byobc/debugger-rev4/firmware/myCMakeLists.txt

cmake_minimum_required(VERSION 3.22)

#
# This file is generated only once,
# and is not re-generated if converter is called multiple times.
#
# User is free to modify the file as much as necessary
#

# Setup compiler settings
set(CMAKE_C_STANDARD 17)
set(CMAKE_CXX_STANDARD 17)
set(CMAKE_C_STANDARD_REQUIRED ON)
set(CMAKE_C_EXTENSIONS ON)

# Define the build type
if(NOT CMAKE_BUILD_TYPE)
    set(CMAKE_BUILD_TYPE "Debug")
endif()

# Set the project name
set(CMAKE_PROJECT_NAME firmware)

# Include toolchain file
include("cmake/gcc-arm-none-eabi.cmake")

# Enable compile command to ease indexing with e.g. clangd
set(CMAKE_EXPORT_COMPILE_COMMANDS ON)

# Core project settings
project(${CMAKE_PROJECT_NAME})
message("Build type: " ${CMAKE_BUILD_TYPE})

# Enable CMake support for ASM and C languages
enable_language(C CXX ASM)

# Create an executable object type
add_executable(${CMAKE_PROJECT_NAME})

# Add STM32CubeMX generated sources
add_subdirectory(cmake/stm32cubemx)

# Link directories setup
target_link_directories(${CMAKE_PROJECT_NAME} PRIVATE
    # Add user defined library search paths
)

# Add sources to executable
target_sources(${CMAKE_PROJECT_NAME} PRIVATE
    # Add user sources here
    ${CMAKE_CURRENT_SOURCE_DIR}/Core/Src/real_main.cpp
    ${CMAKE_CURRENT_SOURCE_DIR}/Core/Src/crc.cpp
    ${CMAKE_CURRENT_SOURCE_DIR}/Core/Src/gpio.cpp
    ${CMAKE_CURRENT_SOURCE_DIR}/Core/Src/message.cpp
    ${CMAKE_CURRENT_SOURCE_DIR}/Core/Src/programmer.cpp
    ${CMAKE_CURRENT_SOURCE_DIR}/Core/Src/uart.cpp

    ${CMAKE_CURRENT_SOURCE_DIR}/lib/physicalW65C02/physicalw65c02.cpp
)

# Add include paths
target_include_directories(${CMAKE_PROJECT_NAME} PRIVATE
    # Add user defined include paths
    ${CMAKE_CURRENT_SOURCE_DIR}/lib/physicalW65C02
    ${CMAKE_CURRENT_SOURCE_DIR}/lib/sim6502
)

# Add project symbols (macros)
target_compile_definitions(${CMAKE_PROJECT_NAME} PRIVATE
    # Add user defined symbols
)

# Remove wrong libob.a library dependency when using cpp files
list(REMOVE_ITEM CMAKE_C_IMPLICIT_LINK_LIBRARIES ob)

# Add linked libraries
target_link_libraries(${CMAKE_PROJECT_NAME}
    stm32cubemx

    # Add user defined libraries
)

# tinyusb
include(${CMAKE_CURRENT_SOURCE_DIR}/lib/tinyusb/src/CMakeLists.txt)
tinyusb_target_add(${CMAKE_PROJECT_NAME})
