byobc/debugger-rev4/pcb/debugger-pcb-rev4.kicad_pcb

## KiCad design pcb/debugger-pcb-rev4.kicad_pcb (2026-01-02)

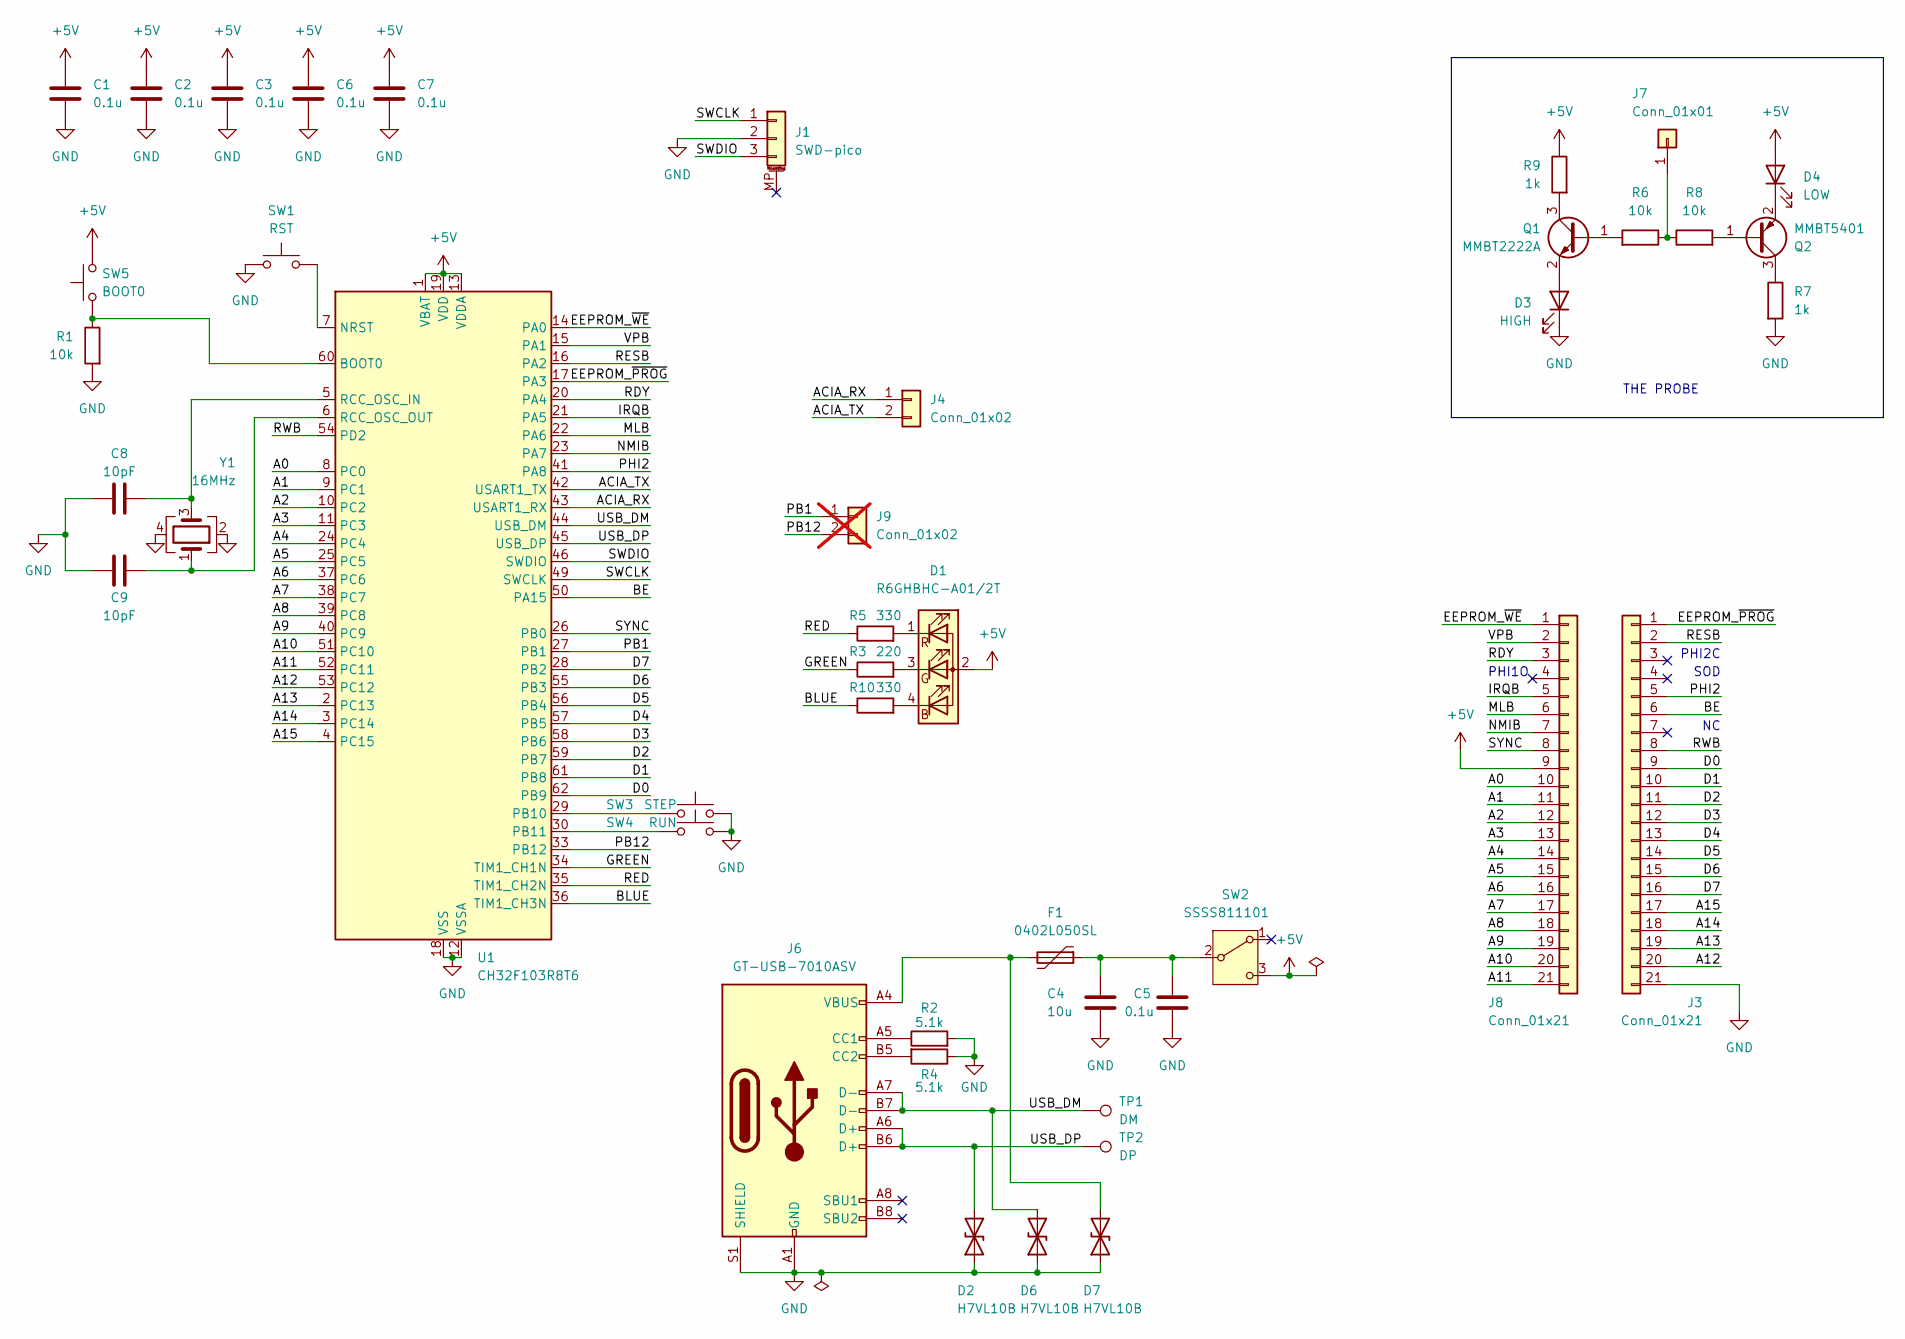
[picture p1: schematic debugger-pcb-rev4.kicad_sch]

Parts:
C1, C2, C3, C5, C6, C7: 0.1u; C_0402_1005Metric; JLC P/N C1525
C4: 10u; C_0402_1005Metric; JLC P/N C15525
C8, C9: 10pF; C_0402_1005Metric; JLC P/N C32949
D1: R6GHBHC-A01/2T; Everlight_0606; JLC P/N C60105
D2, D6, D7: H7VL10B; D_SOD-882; JLC P/N C20615787
D3: HIGH; LED_0805_2012Metric; JLC P/N C2297
D4: LOW; LED_0805_2012Metric; JLC P/N C98225
F1: 0402L050SL; Fuse_0402_1005Metric; JLC P/N C206938
J1: SWD-pico; JST_SH_BM03B-SRSS-TB_1x03-1MP_P1.00mm_Vertical; JLC P/N C3029333
J3, J8: Conn_01x21; PinHeader_1x21_P2.54mm_Vertical_nosilk
J4: Conn_01x02; PinHeader_1x02_P2.54mm_Vertical
J6: GT-USB-7010ASV; USB_C_Receptacle_GCT_USB4105-xx-A_16P_TopMnt_Horizontal; JLC P/N C2988369
J7: Conn_01x01; PinHeader_1x01_P2.54mm_Vertical
J9: Conn_01x02; PinHeader_1x02_P2.54mm_Vertical; not fitted
Q1: MMBT2222A; SOT-523; JLC P/N C94417
Q2: MMBT5401; SOT-523; JLC P/N C2836079
R1, R6, R8: 10k; R_0402_1005Metric; JLC P/N C25744
R2, R4: 5.1k; R_0402_1005Metric; JLC P/N C25905
R3: 220; R_0402_1005Metric; JLC P/N C25091
R5, R10: 330; R_0402_1005Metric; JLC P/N C25104
R7, R9: 1k; R_0402_1005Metric; JLC P/N C11702
SW1: RST; SW_Push_SPST_TS-1088; JLC P/N C720477
SW2: SSSS811101; SW_SPDT_PCM12; JLC P/N C109335
SW3: STEP; SW_Push_SPST_TS-1088; JLC P/N C720477
SW4: RUN; SW_Push_SPST_TS-1088; JLC P/N C720477
SW5: BOOT0; SW_Push_SPST_TS-1088; JLC P/N C720477
TP1: DM; TestPoint_Pad_1.0x1.0mm
TP2: DP; TestPoint_Pad_1.0x1.0mm
U1: CH32F103R8T6; LQFP-64_10x10mm_P0.5mm; JLC P/N C2683478
Y1: 16MHz; Crystal_SMD_3225-4Pin_3.2x2.5mm; JLC P/N C13738

Connections:
+5V: C1.1, C2.1, C3.1, C6.1, C7.1, D1.2 (A), D4.2 (A), J8.9, R9.1, SW2.3 (C), SW5.1, U1.1 (VBAT), U1.13 (VDDA), U1.19 (VDD), U1.32 (VDD), U1.48 (VDD), U1.64 (VDD)
/A0: J8.10, U1.8 (PC0)
/A1: J8.11, U1.9 (PC1)
/A2: J8.12, U1.10 (PC2)
/A3: J8.13, U1.11 (PC3)
/A4: J8.14, U1.24 (PC4)
/A5: J8.15, U1.25 (PC5)
/A6: J8.16, U1.37 (PC6)
/A7: J8.17, U1.38 (PC7)
/A8: J8.18, U1.39 (PC8)
/A9: J8.19, U1.40 (PC9)
/A10: J8.20, U1.51 (PC10)
/A11: J8.21, U1.52 (PC11)
/A12: J3.20, U1.53 (PC12)
/A13: J3.19, U1.2 (PC13)
/A14: J3.18, U1.3 (PC14)
/A15: J3.17, U1.4 (PC15)
/ACIA_RX: J4.1, U1.43 (USART1_RX)
/ACIA_TX: J4.2, U1.42 (USART1_TX)
/BE: J3.6, U1.50 (PA15)
/BLUE: R10.1, U1.36 (TIM1_CH3N)
/D0: J3.9, U1.62 (PB9)
/D1: J3.10, U1.61 (PB8)
/D2: J3.11, U1.59 (PB7)
/D3: J3.12, U1.58 (PB6)
/D4: J3.13, U1.57 (PB5)
/D5: J3.14, U1.56 (PB4)
/D6: J3.15, U1.55 (PB3)
/D7: J3.16, U1.28 (PB2)
/EEPROM_~PROG: J3.1, U1.17 (PA3)
/EEPROM_~WE: J8.1, U1.14 (PA0)
/GREEN: R3.1, U1.34 (TIM1_CH1N)
/IRQB: J8.5, U1.21 (PA5)
/MLB: J8.6, U1.22 (PA6)
/NMIB: J8.7, U1.23 (PA7)
/PB1: J9.1, U1.27 (PB1)
/PB12: J9.2, U1.33 (PB12)
/PHI2: J3.5, U1.41 (PA8)
/RDY: J8.3, U1.20 (PA4)
/RED: R5.1, U1.35 (TIM1_CH2N)
/RESB: J3.2, U1.16 (PA2)
/RWB: J3.8, U1.54 (PD2)
/SWCLK: J1.1, U1.49 (SWCLK)
/SWDIO: J1.3, U1.46 (SWDIO)
/SYNC: J8.8, U1.26 (PB0)
/USB_DM: D6.2 (A2), J6.A7 (D-), J6.B7 (D-), TP1.1, U1.44 (USB_DM)
/USB_DP: D2.2 (A2), J6.A6 (D+), J6.B6 (D+), TP2.1, U1.45 (USB_DP)
/VPB: J8.2, U1.15 (PA1)
GND: C1.2, C2.2, C3.2, C4.2, C5.2, C6.2, C7.2, C8.1, C9.1, D2.1 (A1), D3.1 (K), D6.1 (A1), D7.1 (A1), J1.2, J3.21, J6.A1 (GND), J6.A12 (GND), J6.B1 (GND), J6.B12 (GND), J6.S1 (SHIELD), R1.2, R2.2, R4.1, R7.2, SW1.1, SW3.1, SW4.1, U1.12 (VSSA), U1.18 (VSS), U1.31 (VSS), U1.47 (VSS), U1.63 (VSS), Y1.2, Y1.4
unnamed: D1.4 (BK), R10.2
unnamed: D1.3 (GK), R3.2
unnamed: D1.1 (RK), R5.2
unnamed: D3.2 (A), Q1.2 (E)
unnamed: D4.1 (K), Q2.2 (E)
unnamed: D7.2 (A2), F1.2, J6.A4 (VBUS), J6.A9 (VBUS), J6.B4 (VBUS), J6.B9 (VBUS)
unnamed: J6.A5 (CC1), R2.1
unnamed: J6.B5 (CC2), R4.2
unnamed: J7.1, R6.1, R8.1
unnamed: Q1.1 (B), R6.2
unnamed: Q1.3 (C), R9.2
unnamed: Q2.1 (B), R8.2
unnamed: Q2.3 (C), R7.1
unnamed: C4.1, C5.1, F1.1, SW2.2 (B)
unnamed: R1.1, SW5.2, U1.60 (BOOT0)
unnamed: SW1.2, U1.7 (NRST)
unnamed: SW3.2, U1.29 (PB10)
unnamed: SW4.2, U1.30 (PB11)
unnamed: C8.2, U1.5 (RCC_OSC_IN), Y1.3
unnamed: C9.2, U1.6 (RCC_OSC_OUT), Y1.1

Notes on the sheet:
SOD
THE PROBE
PHI2C
PHI1O

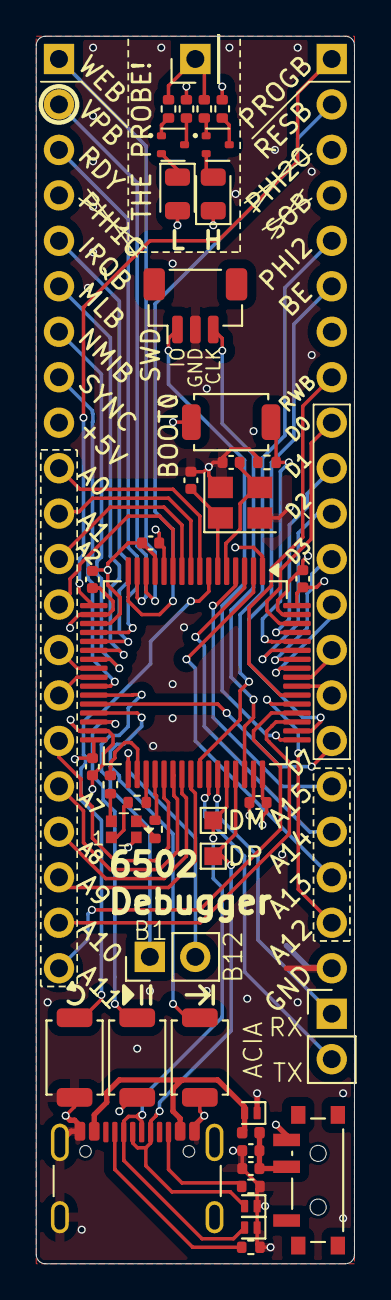
[picture p2: board debugger-pcb-rev4.kicad_pcb from above]

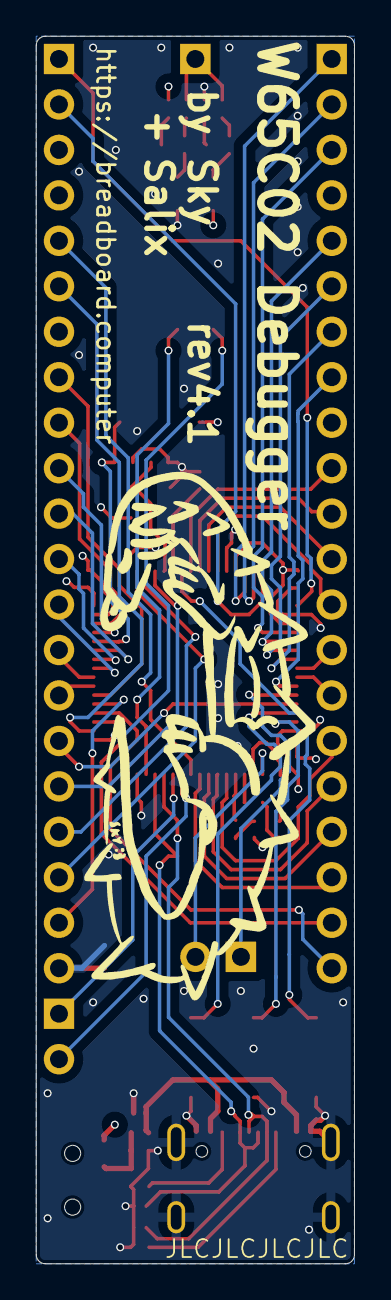
[picture p3: board debugger-pcb-rev4.kicad_pcb from below]

Board: 4 copper layers, 17.8 x 68.6 mm, 44 parts (2 on the bottom side), 69 nets.
