byobc/debugger-rev4/firmware/firmware.ioc

Mcu.UserName=STM32F103R8Tx
PA10.Signal=USART1_RX
PA11.Signal=USB_DM
PA12.Signal=USB_DP
PA7.Signal=TIM1_CH1N
PA9.Signal=USART1_TX
PB0.Signal=TIM1_CH2N
PB1.Signal=TIM1_CH3N
PD0-OSC_IN.Signal=RCC_OSC_IN
PD1-OSC_OUT.Signal=RCC_OSC_OUT
