byobc/debugger-rev4/firmware/Core/Inc/message.h

#pragma once

#include "sim.h"
#include <stdint.h>

struct BusState {
	uint16_t addr;
	bus_status_t status;
	uint8_t data;
	uint8_t _padding;
};

struct CpuState {
	uint16_t addr;
	uint16_t pc;
	uint8_t data;
	uint8_t a;
	uint8_t x;
	uint8_t y;
	uint8_t s;
	uint8_t p;
	uint8_t status; // from LSB to MSB: rwb, sync, vpb, phi2
	uint8_t _padding[2];
	uint8_t mode;
	uint8_t oper;
	uint8_t seq_cycle;
};

enum class CommandType : uint8_t {
	Ping = 0x1,
	WriteEEPROM = 0x2,
	ReadMemory = 0x3,
	SetBreakpoint = 0x4,
	ResetCpu = 0x5,
	GetBusState = 0x6,
	Step = 0x7,
	StepCycle = 0x8,
	StepHalfCycle = 0x9,
	Continue = 0xA,
	HitBreakpoint = 0xB,
	PrintInfo = 0xC,
	GetCpuState = 0xD,
	EnterFastMode = 0xE,
	DebuggerReset = 0xF,
	SectorErase = 0x10,
	MAX_CMD
};

struct WriteEEPROMCmd {
	uint16_t addr;
	uint8_t data[64];
	uint16_t checksum;
};

struct ReadMemoryCmd {
	uint16_t addr;
	uint16_t len;
};

struct SetBreakpointCmd {
	uint16_t addr;
};

struct HitBreakpointCmd {
	uint8_t which;
};

struct SectorEraseCmd {
	uint16_t addr;
};

struct Command {
	CommandType ty;
	union {
		WriteEEPROMCmd write_eeprom;
		ReadMemoryCmd read_memory;
		SetBreakpointCmd set_breakpoint;
		SectorEraseCmd sector_erase;
	};
};

#define ERR_NO_CMD -1
#define ERR_BAD_CMD -2
#define ERR_BAD_ADDR -3
#define ERR_BAD_CHECKSUM -4

// Returns 0 on success and stores the command data in `cmd`.
// Returns ERR_NO_CMD if no command has been sent yet.
int get_command(Command &cmd);

void hit_breakpoint(uint8_t which);
