byobc/debugger-rev4/(commit log)

2025-05-20 Initial commit: incomplete schematic+routing
    [debugger-pcb-rev4.kicad_pcb, debugger-pcb-rev4.kicad_sch]
2025-05-21 more progress: final overall layout
    [debugger-pcb-rev4.kicad_pcb, debugger-pcb-rev4.kicad_sch]
2025-05-23 close to final
    [debugger-pcb-rev4.kicad_pcb, debugger-pcb-rev4.kicad_sch]
2025-05-31 design reviewed and part #s added
    [debugger-pcb-rev4.kicad_pcb, debugger-pcb-rev4.kicad_sch]
2025-05-31 jlc bom script, fix components
    [debugger-pcb-rev4.kicad_sch]
2025-07-13 as ordered for batch 1
    [debugger-pcb-rev4.kicad_pcb, debugger-pcb-rev4.kicad_sch]
2025-09-02 move pcb into subdir
    [debugger-pcb-rev4.kicad_pcb, debugger-pcb-rev4.kicad_sch]
2025-09-05 initial LED setup
2026-01-02 4.1 board revisions done?
    [debugger-pcb-rev4.kicad_pcb, debugger-pcb-rev4.kicad_sch]
